gsitong086-ops/desktop_pet_dog/README.md

[Uploading README.md…]()
================================================================
                    桌面宠物狗（desktop_pet_dog）
            基于 STM32F103C8T6 的四足机器人项目
================================================================

一、项目简介
--------------------------------------------------
本项目是一个基于 STM32F103C8T6 的桌面级四足机器人（宠物狗）。
它通过 4 路舵机驱动四条腿，实现站立、坐、趴下、前进、后退、转向、
跳跃、打招呼、摇手等动作；同时用一块 OLED 屏幕显示小狗的各种表情，
并支持蓝牙、语音（HMI 串口屏）两种方式远程控制，还可通过光敏电阻
感知环境光线自动触发动作，是一款集运动、显示、交互于一体的
嵌入式入门项目。

二、硬件平台
--------------------------------------------------
主控芯片      : STM32F103C8T6
开发工具      : STM32CubeMX + Keil MDK（AC6 编译器）
HAL 库        : STM32F1xx HAL 驱动

主要外设/模块：
 1. 舵机       ：4 路 SG90 舵机（左前、右前、左后、右后四条腿）
 2. OLED 屏   ：128x64 显示小狗表情
 3. 蓝牙模块  ：USART3 通信，手机端控制
 4. 语音/HMI  ：USART2 通信，语音交互 / 串口屏
 5. 光敏电阻  ：ADC1 采样，感知环境光线
 6. WS2812    ：RGB 灯带（预留，用于灯光效果）
 7. 触摸按键  ：外部中断，触发互动动作

三、引脚/外设分配（概要）
--------------------------------------------------
舵机（TIM1 PWM，周期 20ms / 50Hz）：
  LEG1 左前  -> PA8  (TIM1_CH1)
  LEG2 右前  -> PA9  (TIM1_CH2)
  LEG3 左后  -> PA10 (TIM1_CH3)
  LEG4 右后  -> PB13 (TIM1_CH4)

OLED（IIC）：
  SCL -> PB8（上拉、开漏）
  SDA -> PB9（上拉、开漏）

蓝牙（USART3）：PB10(RX) / PB11(TX)，115200bps
语音 HMI（USART2）：DMA + 空闲中断接收，不定长指令
光敏电阻（ADC1）：轮询采样
WS2812 灯带：GPIO 输出（flow_LED 引脚）
触摸按键：外部中断 EXTI

（以上引脚以实际接线和 CubeMX 配置为准）

四、目录结构
--------------------------------------------------
app/        应用层代码（dog、motion、face、protocol 等）
bsp/        底层驱动（舵机、蓝牙、HMI、WS2812、LED、串口等）
module/     软件模块（OLED 显示、软件定时器）
Src/        CubeMX 生成的 HAL 层初始化（main.c 等）
Inc/        对应头文件
Drivers/    CMSIS 与 HAL 标准库
MDK-ARM/    Keil 工程文件

五、核心模块说明
--------------------------------------------------
1. motion（运动控制）
   - 维护 4 个舵机的姿态（-90 ~ 90 度）
   - 姿态类型：站立、坐、趴下、放松趴下
   - 动作类型：前进、后退、左转、右转、向前跳、向后跳、
               摇摆、打招呼、摇手、抬腿等
   - 通过姿态帧 + 线性插值实现平滑过渡，可调速度（0-100）

2. face（表情显示）
   - 封装 OLED 表情的初始化、切换、查询
   - 表情类型：睡觉、瞪眼、开心、狂热、大笑、注视、打招呼等

3. servo（舵机驱动）
   - TIM1 输出 50Hz PWM，控制 SG90 舵机角度
   - 角度与 CCR 对应：-90~90 度 对应 450~2250

4. BlueTooth（蓝牙）
   - USART3 + DMA 循环接收 + 空闲中断
   - 支持不定长数据包接收

5. HMI（语音/串口屏）
   - USART2 + DMA 接收，发送十六进制指令
   - 接收指令后交给 dog.c 的 uart_to_51() 统一分发处理

6. ws2812（RGB 灯带，预留）
   - 提供单灯/多灯/全灯颜色设置与刷新接口

六、控制指令（HMI / 蓝牙收到后分发的动作）
--------------------------------------------------
0x29  躺平（放松趴下）
0x30  蹲下（坐姿）
0x31  起立（站立）
0x32  趴下
0x33  前进
0x34  后退
0x35  左转
0x36  右转
0x37  摇摆
0x38  提高移动速度
0x39  摇手
0x41  向前跳
0x42  向后跳
0x43  打招呼
0x44  前进五步
0xAA  校正（servo_adjust）
0xBB  校正完成（摇摆）
0xCC  复位显示（坐下）

七、主程序流程（main.c）
--------------------------------------------------
1. HAL 初始化、系统时钟配置
2. 初始化各外设（GPIO、DMA、TIM、USART、ADC、SPI 等）
3. 初始化 Face（表情）、OLED 显示开机画面
4. 初始化舵机、HMI、蓝牙、Myit（定时器中断）、运动控制器
5. 主循环中周期性处理：
   - 蓝牙接收处理
   - HMI 接收处理
   - 定时器任务（Myit_process）
   - 光敏检测（adc_light_process，光线变化触发动作）

八、编译与烧录
--------------------------------------------------
1. 用 Keil MDK 打开 MDK-ARM 下的 .uvprojx 工程
2. 编译器选择 AC6，勾选 Use MicroLIB
3. 编译通过后生成 .hex，通过 ST-Link 等工具烧录
4. 上电后 OLED 显示开机画面，即可通过蓝牙/语音控制

九、注意事项
--------------------------------------------------
1. 舵机角度范围请保持在 -90 ~ 90 度，避免堵转损坏
2. 运动为阻塞式插值，执行动作期间会占用主循环，需注意时序
3. 蓝牙与 HMI 均使用"空闲中断 + DMA"，接收缓冲区大小需足够
4. 实际引脚以 CubeMX 配置和接线为准
5. 部分功能（WS2812 灯效、触摸逻辑等）为预留/注释状态，
   可按需启用扩展

================================================================
