gsitong086-ops/desktop_pet_dog/(list of files, drawings)

Other design files:
小狗V1.3/ProPrj_Desktop_Pet_Dog_V1.3.epro
