gsitong086-ops/desktop_pet_dog/Src/main.c

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
/* Includes ------------------------------------------------------------------*/
#include "main.h"
#include "adc.h"
#include "dma.h"
#include "spi.h"
#include "tim.h"
#include "usart.h"
#include "gpio.h"

/* USER CODE BEGIN Includes */
#include "debug.h"
#include "servo.h"
#include "face.h"
#include "bsp_LED.h"
#include "bsp_uart.h"
#include "OLED.h"
#include "motion.h"
#include "delay.h"
#include "ws2812.h"
#include "HMI.h"
#include "BlueTooth.h"
#include "Myit.h"
/* USER CODE END Includes */


/* USER CODE BEGIN PV */
volatile uint8_t Myit_f = 0;
volatile uint8_t touch_f = 0;
uint8_t touch_level_last = 0;
uint8_t touch_level_now = 0;

// 要发送的十六进制数值
uint8_t hex_data[] = {0xAA};
size_t data_length = sizeof(hex_data) / sizeof(hex_data[0]);

Face_HandleTypeDef hface;

// 创建运动控制器实例
Motion_HandleTypeDef hMotion;

uint8_t dog_light_f = 1;
uint16_t time_cnt = 0;
/* USER CODE END PV */

void SystemClock_Config(void);
/* USER CODE BEGIN PFP */
void adc_light_process(void);
void Myit_process(void);
/* USER CODE END PFP */

/**
  * @brief  The application entry point.
  * @retval int
  */
int main(void)
{

  /* MCU Configuration--------------------------------------------------------*/

  /* Reset of all peripherals, Initializes the Flash interface and the Systick. */
  HAL_Init();

  /* Configure the system clock */
  SystemClock_Config();

  /* Initialize all configured peripherals */
  MX_GPIO_Init();
  MX_DMA_Init();
  MX_TIM2_Init();
  MX_TIM3_Init();
  MX_USART1_UART_Init();
  MX_USART2_UART_Init();
  MX_USART3_UART_Init();
  MX_ADC1_Init();
  MX_SPI2_Init();
  MX_TIM1_Init();
  MX_TIM4_Init();
  /* USER CODE BEGIN 2 */
  
//  __disable_irq();
  HAL_Delay(500);
  
  Face_Init(&hface, NULL);
  
  HAL_ADC_Stop(&hadc1);
  HAL_ADCEx_Calibration_Start(&hadc1);
  HAL_Delay(20);
  HAL_ADC_Start(&hadc1);
  
  OLED_Clear();
  OLED_ShowImage(22, 0, 86, 64, OSHAImg);
  OLED_Update();
  HAL_Delay(800);
  OLED_Clear();
  OLED_ShowImage(38,10,80,80,rosydoedian);
  OLED_Update();
  HAL_Delay(800);
  
  hex_data[0] = 0x99;
  HMI_send_hex_values(hex_data, data_length);
  
  servo_Init();
  HMI_Init();
  BLUETOOTH_Init();
  Myit_Init();
  
//  __enable_irq();

  // 初始化运动控制器
  motion_init(&hMotion);
  
  // 设置运动速度为70（范围0-100）
  motion_set_speed(&hMotion, 70);
  
  // 演示基本姿态切换
  motion_set_pose(&hMotion, POSE_STAND);    // 站立
//  HAL_Delay(1000);                          // 等待1秒
  /* USER CODE END 2 */

  /* Infinite loop */
  /* USER CODE BEGIN WHILE */
  while (1)
  {
    BLUETOOTH_process_information();
    HMI_process_information();
    
    Myit_process();
    
    adc_light_process();
    
    /* USER CODE END WHILE */

    /* USER CODE BEGIN 3 */
  }
  /* USER CODE END 3 */
}

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
/* USER CODE BEGIN 4 */
void face_test(void)
{
    OLED_ShowImage(0, 0, 128, 64, BMP1);
    OLED_Update();
    HAL_Delay(500);
    OLED_ShowImage(0, 0, 128, 64, BMP2);
    OLED_Update();
    HAL_Delay(500);
    OLED_ShowImage(0, 0, 128, 64, BMP3);
    OLED_Update();
    HAL_Delay(500);
    OLED_ShowImage(0, 0, 128, 64, BMP4);
    OLED_Update();
    HAL_Delay(500);
    OLED_ShowImage(0, 0, 128, 64, BMP5);
    OLED_Update();
    HAL_Delay(500);
    OLED_ShowImage(0, 0, 128, 64, BMP6);
    OLED_Update();
    HAL_Delay(500);
    OLED_ShowImage(0, 0, 128, 64, BMP7);
    OLED_Update();
    HAL_Delay(500);
    OLED_ShowImage(0, 0, 128, 64, BMPaa);
    OLED_Update();
    HAL_Delay(500);
    OLED_ShowImage(0, 0, 128, 64, BMPbb);
    OLED_Update();
    HAL_Delay(500);
    OLED_ShowImage(0, 0, 128, 64, BMPcc);
    OLED_Update();
    HAL_Delay(500);
    OLED_ShowImage(0, 0, 128, 64, BMPdd);
    OLED_Update();
    HAL_Delay(500);
    OLED_ShowImage(0, 0, 128, 64, BMPee);
    OLED_Update();
    HAL_Delay(500);
}
void adc_light_process(void){
    HAL_ADC_PollForConversion(&hadc1, 20);
    printf("LDR ADC : %d,\n", HAL_ADC_GetValue(&hadc1));
    if(HAL_ADC_GetValue(&hadc1) <= 150 && dog_light_f)
    {
      dog_light_f = 0;
      hex_data[0] = 0xAA;
      HMI_send_hex_values(hex_data, data_length);
    }else if(HAL_ADC_GetValue(&hadc1) >= 1000 && !dog_light_f){
      hex_data[0] = 0xDD;
      HMI_send_hex_values(hex_data, data_length);
      OLED_ShowImage(0, 0, 128, 64, BMPcc);
      OLED_Update();
      time_cnt = 0;
      dog_light_f = 1;
    }
}
void Myit_process(void){
    if(Myit_f)
    {
      LED_Toggle();
      Myit_f = 0;
      time_cnt++;
      if(time_cnt >=120)
      {
        time_cnt = 0;
        OLED_ShowImage(0, 0, 128, 64, BMP1);
        OLED_Update();
      }
    }
}
/* USER CODE END 4 */
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
