gsitong086-ops/desktop_pet_dog/desktop_pet_dog.ioc

Mcu.UserName=STM32F103C8Tx
PA0-WKUP.Signal=S_TIM2_CH1_ETR
PA10.GPIO_Label=servo3
PA10.Signal=S_TIM1_CH3
PA11.GPIO_Label=servo4
PA11.Signal=S_TIM1_CH4
PA12.GPIO_Label=flow_LED
PA12.Signal=GPIO_Output
PA13.Signal=SYS_JTMS-SWDIO
PA14.Signal=SYS_JTCK-SWCLK
PA2.GPIO_Label=TX2_ASRPRO
PA2.Signal=USART2_TX
PA3.GPIO_Label=RX2_ASRPRO
PA3.Signal=USART2_RX
PA5.GPIO_Label=light
PA5.Signal=ADCx_IN5
PA7.GPIO_Label=touch
PA7.Signal=GPXTI7
PA8.GPIO_Label=servo1
PA8.Signal=S_TIM1_CH1
PA9.GPIO_Label=servo2
PA9.Signal=S_TIM1_CH2
PB10.GPIO_Label=TX3_Bluetooth
PB10.Signal=USART3_TX
PB11.GPIO_Label=RX3_Bluetooth
PB11.Signal=USART3_RX
PB13.Signal=SPI2_SCK
PB14.Signal=SPI2_MISO
PB15.Signal=SPI2_MOSI
PB6.GPIO_Label=TX1_Debug
PB6.Signal=USART1_TX
PB7.GPIO_Label=RX1_Debug
PB7.Signal=USART1_RX
PB8.GPIO_Label=My_OLED_SDA
PB8.Signal=GPIO_Output
PB9.GPIO_Label=My_OLED_SCL
PB9.Signal=GPIO_Output
PC13-TAMPER-RTC.GPIO_Label=LED
PC13-TAMPER-RTC.Signal=GPIO_Output
PD0-OSC_IN.Signal=RCC_OSC_IN
PD1-OSC_OUT.Signal=RCC_OSC_OUT
