gsitong086-ops/desktop_pet_dog/Inc/main.h

#define LED_Pin GPIO_PIN_13
#define LED_GPIO_Port GPIOC
#define TX2_ASRPRO_Pin GPIO_PIN_2
#define TX2_ASRPRO_GPIO_Port GPIOA
#define RX2_ASRPRO_Pin GPIO_PIN_3
#define RX2_ASRPRO_GPIO_Port GPIOA
#define light_Pin GPIO_PIN_5
#define light_GPIO_Port GPIOA
#define touch_Pin GPIO_PIN_7
#define touch_GPIO_Port GPIOA
#define touch_EXTI_IRQn EXTI9_5_IRQn
#define TX3_Bluetooth_Pin GPIO_PIN_10
#define TX3_Bluetooth_GPIO_Port GPIOB
#define RX3_Bluetooth_Pin GPIO_PIN_11
#define RX3_Bluetooth_GPIO_Port GPIOB
#define servo1_Pin GPIO_PIN_8
#define servo1_GPIO_Port GPIOA
#define servo2_Pin GPIO_PIN_9
#define servo2_GPIO_Port GPIOA
#define servo3_Pin GPIO_PIN_10
#define servo3_GPIO_Port GPIOA
#define servo4_Pin GPIO_PIN_11
#define servo4_GPIO_Port GPIOA
#define flow_LED_Pin GPIO_PIN_12
#define flow_LED_GPIO_Port GPIOA
#define TX1_Debug_Pin GPIO_PIN_6
#define TX1_Debug_GPIO_Port GPIOB
#define RX1_Debug_Pin GPIO_PIN_7
#define RX1_Debug_GPIO_Port GPIOB
#define My_OLED_SDA_Pin GPIO_PIN_8
#define My_OLED_SDA_GPIO_Port GPIOB
#define My_OLED_SCL_Pin GPIO_PIN_9
#define My_OLED_SCL_GPIO_Port GPIOB
