gsitong086-ops/desktop_pet_dog/bsp/BlueTooth.c

/**
  ******************************************************************************
  * @file    BLUETOOTH.c
  * @author  SZTU OSHA 深圳技术大学开源硬件社 [YourName]
  * @brief   蓝牙模块通信驱动实现
  *          提供蓝牙模块的初始化、数据发送和接收处理功能
  * @version 1.0.0
  * @date    [YYYY-MM-DD]
  * @license GPL-3.0-only
  ******************************************************************************
  * @attention
  * 
  * 本驱动依赖于HAL库UART和DMA功能，使用前需确保相关外设已正确配置
  * 中断服务程序中需处理UART空闲中断并设置接收标志位
  * 
  ******************************************************************************
  * @implementation
  * - 实现原理: 通过UART+DMA方式实现蓝牙模块的高效数据收发
  *             利用空闲中断检测数据包结束，DMA实现无CPU干预的数据接收
  * - 算法描述: 采用固定包头+指令码的简单协议格式，支持2字节短指令
  *             接收数据时通过长度判断指令合法性，超过3字节视为错误指令
  * 
  * 注意：
  * 1. 需在中断服务程序中处理UART空闲中断并设置接收标志位
  * 2. 缓冲区大小BLUETOOTH_DMA_LENGTH需根据实际最大数据包长度配置
  ******************************************************************************
  */

/* 包含头文件 | Includes -----------------------------------------------------*/
#include "BlueTooth.h"   // 包含头文件，确保宏和函数声明一致
#include <stdio.h>

/* 私有宏定义 | Private macros -----------------------------------------------*/
#define DEBUG_BLUETOOTH_Printf    1     /* 蓝牙调试信息打印使能 */

/* 私有类型定义 | Private types ----------------------------------------------*/
/* 无特殊类型定义 */

/* 模块私有变量 | Private variables ------------------------------------------*/
volatile uint8_t BLUETOOTH_RxFlag = 0;       /* 蓝牙接收完成标志位 */
uint8_t BlueTooth_TxBuffer[50] = {0x00};     /* 蓝牙发送缓冲区 */
uint8_t BlueTooth_RxBuffer[BLUETOOTH_DMA_LENGTH] = {0x00};  /* 蓝牙接收缓冲区 */
uint8_t BlueTooth_RxCount = 0;               /* 蓝牙接收数据长度计数 */

/* 外部变量声明 | External variables -----------------------------------------*/
extern UART_HandleTypeDef BLUETOOTH_UART;    /* 蓝牙UART句柄 */
extern DMA_HandleTypeDef BLUETOOTH_DMA;      /* 蓝牙DMA句柄 */

/* 私有函数原型 | Private function prototypes --------------------------------*/
/* 无私有函数 */

/* 公有函数实现 | Public functions -------------------------------------------*/

/**
  * @brief  初始化BLUETOOTH通信接口
  * @details 
  *   配置BLUETOOTH串口通信参数并启动DMA接收
  *   - 使能UART空闲中断用于检测消息结束
  *   - 配置DMA循环模式接收数据
  *   - 缓冲区溢出处理依赖于应用层实现
  * 
  * @note 
  *   1. 需确保BLUETOOTH_UART已正确初始化
  *   2. RxBuffer必须足够大以容纳最长的BLUETOOTH响应
  *   3. 建议在系统初始化阶段调用此函数
  * 
  * @retval 无
  * 
  * @see BLUETOOTH_UART
  * @see BlueTooth_RxBuffer
  * @see BLUETOOTH_DMA_LENGTH
  */
void BLUETOOTH_Init(void)
{
  // 使能空闲中断
  __HAL_UART_ENABLE_IT(&BLUETOOTH_UART, UART_IT_IDLE);
  // 开启接收DMA
  HAL_UART_Receive_DMA(&BLUETOOTH_UART, (uint8_t *)BlueTooth_RxBuffer, BLUETOOTH_DMA_LENGTH);
}

/**
  * @brief  根据指令类型向BLUETOOTH发送信息
  * @details 
  *   根据传入的指令代码，执行对应的BLUETOOTH控制逻辑
  *   支持的指令类型定义在本头文件中（INS1-INS3）
  * 
  * @param  instruction 指令类型
  *         取值范围: INS1-INS3 (定义在BlueTooth.h中)
  * 
  * @note 
  *   1. 函数内部根据指令类型执行不同的发送逻辑
  *   2. 每个指令的具体实现需要在对应分支中完成
  *   3. 未匹配的指令将被忽略
  * 
  * @retval 无
  * 
  * @see INS1, INS2, INS3
  */
void BLUETOOTH_send_information(uint8_t instruction)
{
  if(instruction == INS1)
  {
    // 指令1的发送逻辑实现（示例：填充发送缓冲区并通过UART发送）
    BlueTooth_TxBuffer[0] = BLUETOOTH_TO_STM32_HEADER;  // 包头
    BlueTooth_TxBuffer[1] = INS1;                       // 指令码
    HAL_UART_Transmit_DMA(&BLUETOOTH_UART, BlueTooth_TxBuffer, 2);
  }
  else if(instruction == INS2)
  {
    // 指令2的发送逻辑实现
    BlueTooth_TxBuffer[0] = BLUETOOTH_TO_STM32_HEADER;
    BlueTooth_TxBuffer[1] = INS2;
    HAL_UART_Transmit_DMA(&BLUETOOTH_UART, BlueTooth_TxBuffer, 2);
  }
  else if(instruction == INS3)
  {
    // 指令3的发送逻辑实现
    BlueTooth_TxBuffer[0] = BLUETOOTH_TO_STM32_HEADER;
    BlueTooth_TxBuffer[1] = INS3;
    HAL_UART_Transmit_DMA(&BLUETOOTH_UART, BlueTooth_TxBuffer, 2);
  }
}

/**
  * @brief  处理从BLUETOOTH接收的数据
  * @details 
  *   检查接收标志位，处理BLUETOOTH发送过来的指令
  *   支持两种指令格式:
  *   1. 2字节指令: [包头][指令码]
  *   2. 长度>3的指令: 目前作为错误处理
  * 
  * @note 
  *   1. 需在UART中断服务程序中置位RxFlag
  *   2. 处理完成后自动重启DMA接收
  *   3. 调试模式下会打印接收数据的详细信息
  * 
  * @retval 无
  * 
  * @see BLUETOOTH_IRQHandler()
  * @see BLUETOOTH_TO_STM32_HEADER
  */
void BLUETOOTH_process_information(void)
{
  // 检查接收标志位（在UART中断服务程序中设置）
  if(BLUETOOTH_RxFlag)
  {
    BLUETOOTH_RxFlag = 0;
    HAL_UART_DMAStop(&BLUETOOTH_UART);
    BlueTooth_RxCount = BLUETOOTH_DMA_LENGTH - __HAL_DMA_GET_COUNTER(&BLUETOOTH_DMA);
    
    #if DEBUG_BLUETOOTH_Printf == 1
    printf("<BLUETOOTH UART3 Rx Flag!>\n");
    #endif
    
    // 根据接收数据长度处理不同类型的指令
    if(BlueTooth_RxCount == 2)
    {
      // 校验包头并处理对应指令
      if(BlueTooth_RxBuffer[0] == BLUETOOTH_TO_STM32_HEADER && BlueTooth_RxBuffer[1] == 0x00)
      {
        // 处理0x00指令（示例：触发某个动作）
        #if DEBUG_BLUETOOTH_Printf == 1
        printf("Received command: 0x00\n");
        #endif
      }
      else if(BlueTooth_RxBuffer[0] == BLUETOOTH_TO_STM32_HEADER && BlueTooth_RxBuffer[1] == 0x01)
      {
        // 处理0x01指令
        #if DEBUG_BLUETOOTH_Printf == 1
        printf("Received command: 0x01\n");
        #endif
      }
    }
    else if(BlueTooth_RxCount > 3)
    {
      printf("Instruction error! Length: %d\n", BlueTooth_RxCount);
    }
    
    #if DEBUG_BLUETOOTH_Printf == 1
    // 打印接收到的指令，提供调试信息
    for(uint8_t i = 0; i < BlueTooth_RxCount; i++)
    {
      if((i % 4) == 0 && i != 0) {         // 每四个字节换一次行
        printf("\n");
      }
      printf("%02X ", BlueTooth_RxBuffer[i]);  // 以两位十六进制格式输出
    }
    printf("\n");
    #endif
    
    // 重启DMA继续接收数据
    HAL_UART_Receive_DMA(&BLUETOOTH_UART, (uint8_t *)BlueTooth_RxBuffer, BLUETOOTH_DMA_LENGTH);
  }
}

/* 私有函数实现 | Private functions ------------------------------------------*/
/* 无私有函数实现 */
