gsitong086-ops/desktop_pet_dog/bsp/Face_Config.c

//#include "BlueTooth.h"
#include "Face_Config.h"
//实现表情变化，调节是进中断后
static uint16_t Face_Mode = 0;

void Face_Config(void)
{
  
	if(Face_Mode==0)
	{	
		OLED_Clear();
		OLED_ShowImage(0,0,128,64,Face_sleep);//睡觉
		OLED_Update();
	}
	else if(Face_Mode==1)
	{	
		OLED_Clear();
		OLED_ShowImage(0,0,128,64,Face_stare);//瞪大眼
		OLED_Update();
	}
	else if(Face_Mode==2)
	{
		OLED_Clear();
		OLED_ShowImage(0,0,128,64,Face_happy);//快乐
		OLED_Update();
	}
	else if(Face_Mode==3)
	{
		OLED_Clear();
		OLED_ShowImage(0,0,128,64,Face_mania);//狂热
		OLED_Update();
	}
	else if(Face_Mode==4)
	{
		OLED_Clear();
		OLED_ShowImage(0,0,128,64,Face_very_happy);//非常快乐
		OLED_Update();
	}
	else if(Face_Mode==5)
	{
		OLED_Clear();
		OLED_ShowImage(0,0,128,64,Face_eyes);//眼睛
		OLED_Update();
	}
	else if(Face_Mode==6)
	{
		OLED_Clear();
		OLED_ShowImage(0,0,128,64,Face_hello);//打招呼
		OLED_Update();
	}
}
