gsitong086-ops/desktop_pet_dog/app/dog.h

/**
  ******************************************************************************
  * @file    dog.h
  * @author  SZTU OSHA 深圳技术大学开源硬件社 [YourName]
  * @brief   [模块功能简要描述] 
  * @version 1.0.0
  * @date    [YYYY-MM-DD]
  * @license GPL-3.0-only
  ******************************************************************************
  */

/* 防止递归包含保护 | Prevent recursive inclusion */
#ifndef __DOG_H__
#define __DOG_H__

#ifdef __cplusplus
extern "C" {
#endif

/* 包含头文件 | Includes -------------------------------------------------------*/
#include "main.h"

/* 宏定义 | Macros -------------------------------------------------------------*/


/* 状态码定义 | Status code definitions */


/* 类型定义 | Types -------------------------------------------------------------*/


/* 函数声明 | Function prototypes -----------------------------------------------*/
void uart_to_51(void);

#ifdef __cplusplus
}
#endif

#endif /* __DOG_H__ */
