gsitong086-ops/desktop_pet_dog/app/protocol.c

/**
  ******************************************************************************
  * @file    xxx.c
  * @author  SZTU OSHA 深圳技术大学开源硬件社 [YourName]
  * @brief   [模块功能详细描述]
  * @version 1.0.0
  * @date    [YYYY-MM-DD]
  * @license GPL-3.0-only
  ******************************************************************************
  * @attention
  * 
  * 
  ******************************************************************************
  * @implementation
  * - 实现原理: [技术实现原理说明] 
  * - 算法描述: [使用的算法说明] 
  * 
  * 注意：  Note:
  * 1. [核心实现注意事项] 
  ******************************************************************************
  */

/* 包含头文件 | Includes -----------------------------------------------------*/


/* 私有宏定义 | Private macros -----------------------------------------------*/


/* 私有类型定义 | Private types ----------------------------------------------*/


/* 模块私有变量 | Private variables ------------------------------------------*/


/* 私有函数原型 | Private function prototypes --------------------------------*/


/* 公有函数实现 | Public functions -------------------------------------------*/


/* 私有函数实现 | Private functions ------------------------------------------*/
